nanase/japariradio/docs/index.md

---
layout: default
title: JapariRadio

header_top: true
header_title: JapariRadio
header_version: Rev.3
header_image: /assets/img/title/rev3.jpg
header_label: [supported]

subpages:
  - title: 頒布情報
    page: distribution
  - title: 更新履歴
    page: updates
---

## 特徴

JapariRadio は手のひらサイズの FM ラジオ受信機です。シンプル操作でどこでも使いやすい 2 ボタン、音量ボリュームを採用し、さらに単 4 電池 1 本から動作します。

<table class="borderless-table no-image-border less-padding foot-note text-center center-table" style="max-width: 600px">
  <tbody>
    <tr>
      <td>
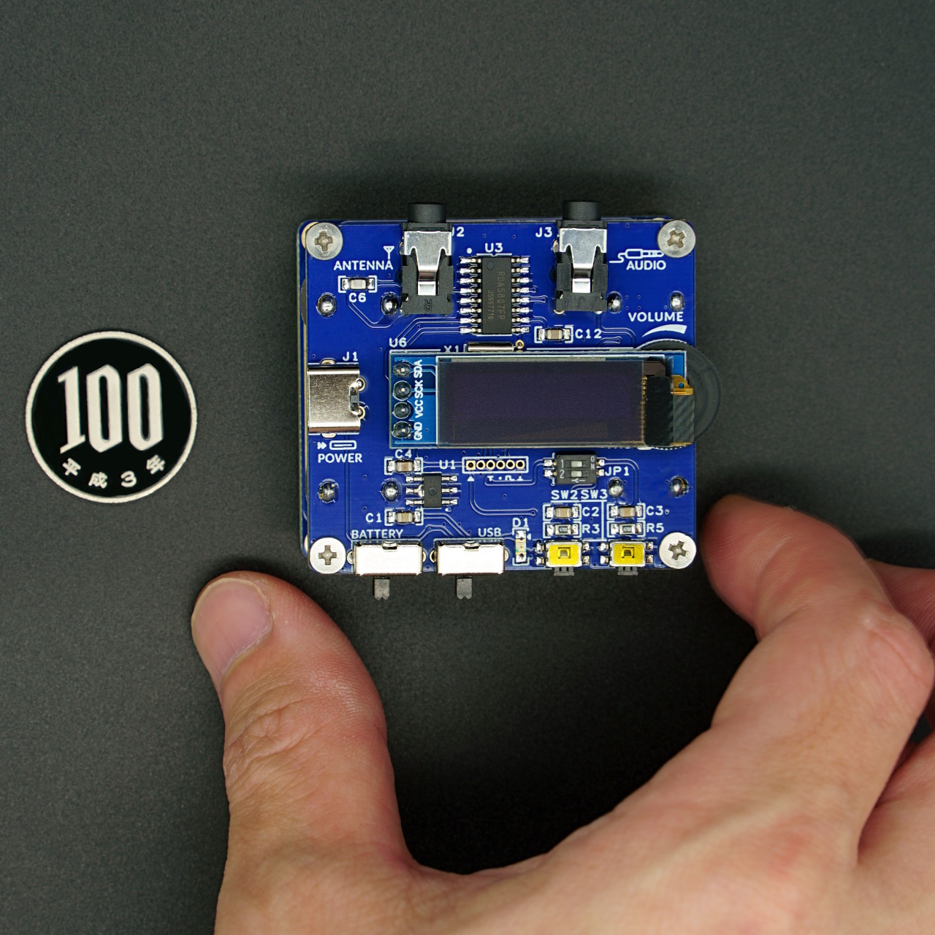
[picture p1: docs/assets/img/rev3_photo.jpg]
        <br />
        51g の手のひらサイズ<br />
        持ち歩きにも便利です
      </td>
      <td>
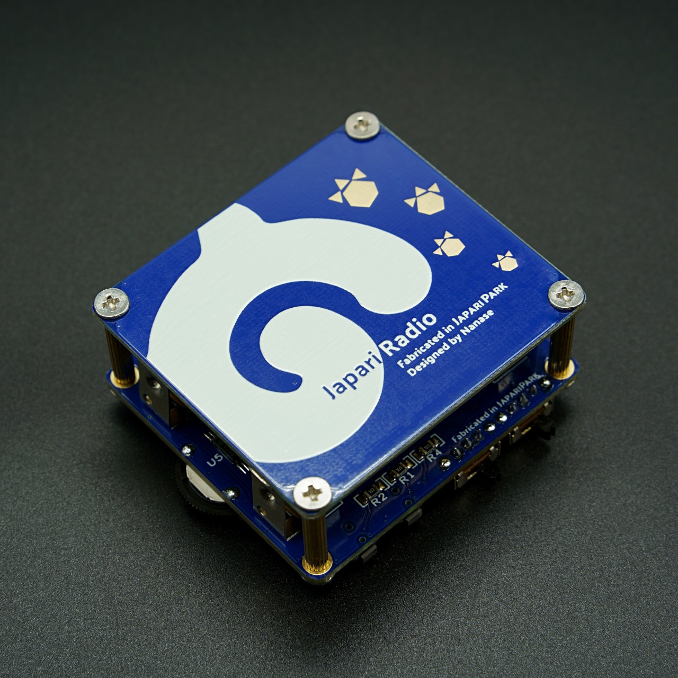
[picture p2: docs/assets/img/rev3_photo2.jpg]
        <br />
        背面は部品がなくすっきり<br />
        ロゴを目立たせています
      </td>
    </tr>
  </tbody>
</table>

## つかいかた

- 電池スイッチ：電池使用時に使います。
- USB スイッチ：未使用時は電源を切れます。
- 選局 / シークボタン：0.1 MHz ごとに選曲ができます。長押しでシークができます。
- 音量ボリューム：シンプルで使いやすいロータリーボリュームを採用しています。
- オーディオ出力ジャック：ステレオ対応の 3.5mm イヤホンジャックです。
- 外付けアンテナジャック：受信感度が低く屋内でも快適に聴取できます。

<div class="no-image-border text-center center-table" style="max-width: 600px">
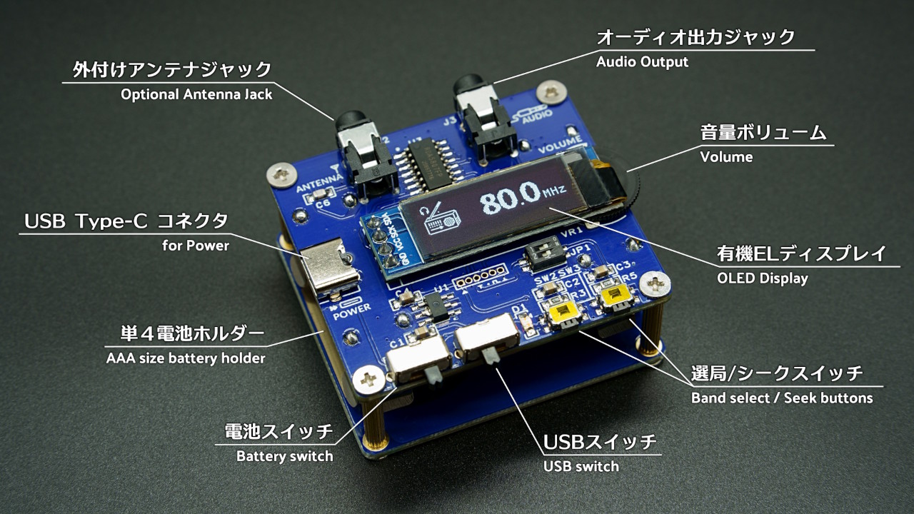
[picture p3: docs/assets/img/rev3_usage.jpg]
  
</div>

## 使用上の注意

- ディスプレイに有機 EL を使用しているため、長期間使用すると輝度に偏りが発生しますが異常ではありません。
- 受信感度が低い条件下で十分に聴取できない場合、外付けアンテナを使用すると受信感度が改善することがあります。
- 地域ごとの FM 局一覧はこちら: [NHK](https://www.nhk.or.jp/radio/info/frequency.html?ch=fm) [民放](https://www.soumu.go.jp/menu_seisaku/ictseisaku/housou_suishin/fm-list.html)

## こんなときは

- 電源が入らない、ディスプレイに何も表示されない：USB ケーブルの接続を確認してください。
- ディスプレイが暗い：受信周波数を変えてしばらくすると、省電力とディスプレイの寿命向上のため自動的に画面輝度が低くなります。再度受信周波数を変えると画面の輝度が元に戻ります。
- 雑音しか聞こえない：受信感度の高い屋外で使用するか、外付けアンテナを使ってください。

## 仕様

<table class="spec-table">
  <tbody>
    <tr>
      <th>製品名</th>
      <td>JapariRadio Rev.3</td>
    </tr>
    <tr>
      <th>製作期</th>
      <td>2022.05</td>
    </tr>
  </tbody>
</table>

<table class="spec-table">
  <tbody>
    <tr>
      <th>ラジオIC</th>
      <td>RDA5807FP</td>
    </tr>
    <tr>
      <th>受信周波数範囲</th>
      <td>76.0～108.0 MHz (0.1 MHz 刻み)</td>
    </tr>
    <tr>
      <th>出力チャネル</th>
      <td>ステレオ対応（受信可能時のみ）</td>
    </tr>
    <tr>
      <th>ボリューム</th>
      <td>基板右側面にて調整</td>
    </tr>
    <tr>
      <th>シーク機能</th>
      <td>あり（ボタン長押し）</td>
    </tr>
    <tr>
      <th>受信周波数記憶機能</th>
      <td>あり</td>
    </tr>
    <tr>
      <th>外付けアンテナ</th>
      <td>取付可能（アンテナ端子あり）</td>
    </tr>
  </tbody>
</table>

<table class="spec-table">
  <tbody>
    <tr>
      <th>ディスプレイ</th>
      <td>128x32 ドット 0.91 インチ 有機 EL ディスプレイ</td>
    </tr>
    <tr>
      <th>表示アイコン</th>
      <td>受信周波数、ステレオ受信、受信強度</td>
    </tr>
    <tr>
      <th>輝度</th>
      <td>無操作時は自動で低輝度モードへ移行、時間経過で消灯</td>
    </tr>
  </tbody>
</table>

<table class="spec-table">
  <tbody>
    <tr>
      <th>電源</th>
      <td>DC 5V (USB Type-C 端子) または 単4電池 1～2 本</td>
    </tr>
    <tr>
      <th>消費電力</th>
      <td>40mA (最大)</td>
    </tr>
  </tbody>
</table>

<table class="spec-table">
  <tbody>
    <tr>
      <th>大きさ（本体のみ）</th>
      <td>約 50.0（幅） x18.0（高さ） x45.0（奥行） mm</td>
    </tr>
    <tr>
      <th>大きさ（突起物含む）</th>
      <td>約 53.5（幅） x23.0（高さ） x52.5（奥行） mm</td>
    </tr>
    <tr>
      <th>質量</th>
      <td>約 51 g（電池含む）</td>
    </tr>
  </tbody>
</table>

## ドキュメント

<table class="spec-table">
  <tbody>
    <tr>
      <th>図面</th>
      <td class="no-image-border text-center">
        <div class="inline-block">
          <a href="{{site.baseurl}}/assets/pdf/rev3_schematics.pdf" target="_blank">
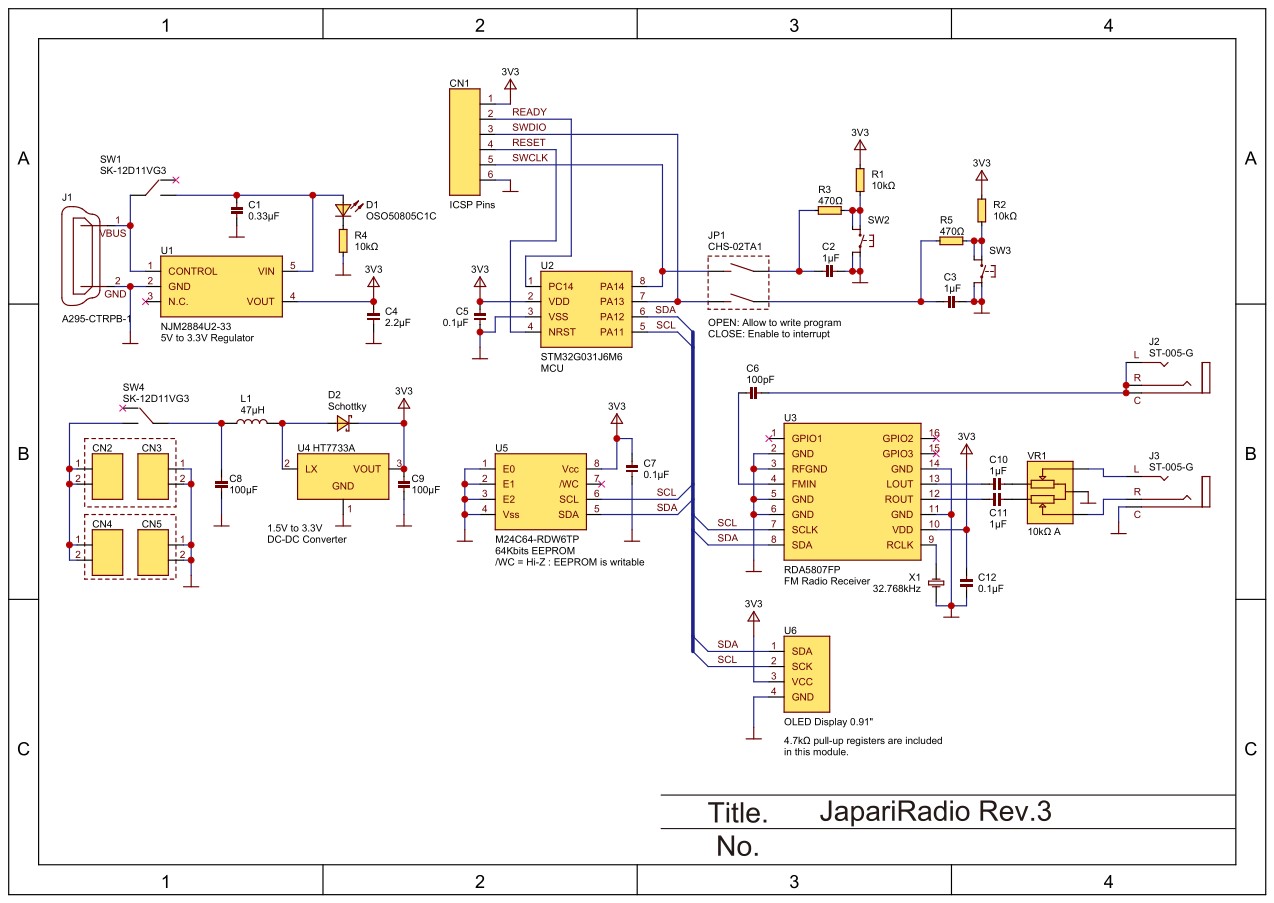
[picture p4: docs/assets/img/pdf_thumb/rev3_schematics.jpg]
            <br />
            回路図
          </a>
        </div>
        <div class="inline-block">
          <a href="{{site.baseurl}}/assets/pdf/rev3_pcb_top.pdf" target="_blank">
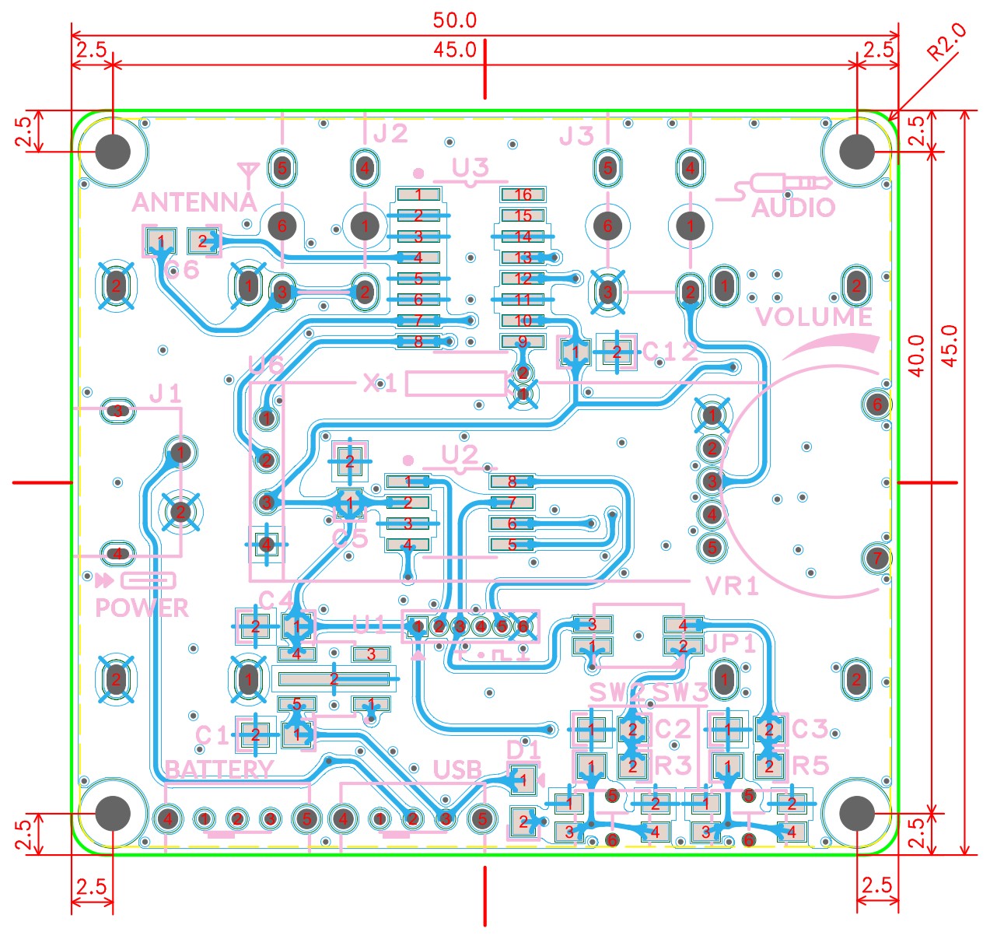
[picture p5: docs/assets/img/pdf_thumb/rev3_pcb_top.jpg]
            <br />
            基板表面
          </a>
        </div>
        <div class="inline-block">
          <a href="{{site.baseurl}}/assets/pdf/rev3_pcb_bottom.pdf" target="_blank">
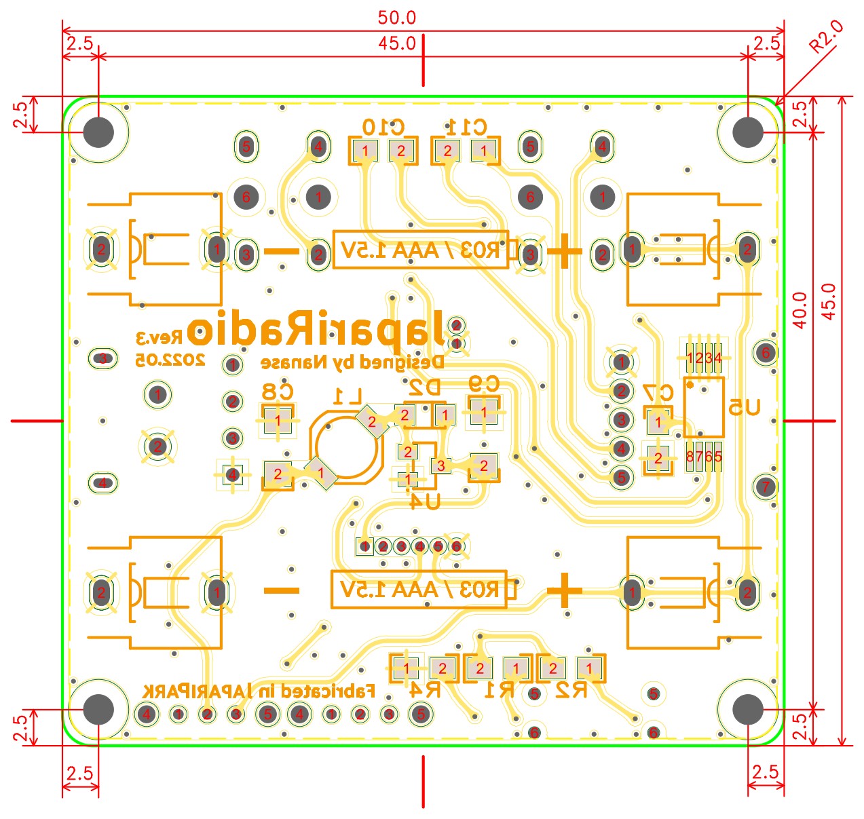
[picture p6: docs/assets/img/pdf_thumb/rev3_pcb_bottom.jpg]
            <br />
            基板裏面
          </a>
        </div>
      </td>
    </tr>
  </tbody>
</table>

## ライセンス

**この作品は「けものフレンズ」の非公式ファン作品です。** 使用により生じた損失については責任を負いかねます。

<table class="spec-table">
  <tbody>
    <tr>
      <th>
        <a href="https://fonts.google.com/specimen/Palanquin+Dark#about" target="_blank">Palanquin Dark</a><br />
        <span class="foot-note">by Pria Ravichandran</span>
      </th>
      <td>
        <span class="foot-note">Font for Logo and Text on board</span><br />
        These fonts are licensed under the <a href="https://scripts.sil.org/cms/scripts/page.php?site_id=nrsi&id=OFL" target="_blank">Open Font License</a>.
      </td>
    </tr>
    <tr>
      <th>
        <a href="https://fonts.google.com/specimen/Lato#about" target="_blank">Lato</a><br />
        <span class="foot-note">by Łukasz Dziedzic</span>
      </th>
      <td>
        <span class="foot-note">Font for Text on board</span><br />
        These fonts are licensed under the <a href="https://scripts.sil.org/cms/scripts/page.php?site_id=nrsi&id=OFL" target="_blank">Open Font License</a>.
      </td>
    </tr>
  </tbody>
</table>

<table class="spec-table">
  <tbody>
    <tr>
      <th>
        <a href="https://github.com/4ilo/ssd1306-stm32HAL" target="_blank">ssd1306-stm32HAL</a><br />
        <span class="foot-note">by 4ilo</span>
      </th>
      <td>
        <span class="foot-note">Display program and Font data</span><br />
        <a href="https://github.com/4ilo/ssd1306-stm32HAL/blob/master/LICENSE.md" target="_blank">MIT License</a>
      </td>
    </tr>
  </tbody>
</table>

## 製作・制作

- 基板設計・実装・プログラム開発：七瀬 [@nanase_coder](https://twitter.com/nanase_coder)
- スペシャルサンクス：スティルマンさん [@lp_stillman](https://twitter.com/lp_stillman)

<p class="text-center margin-50 epitaph">Designed by Nanase, Fabricated in <span class="small-caps">JapariPark</span></p>
