nanase/japariradio/docs/updates.md

---
layout: default
title: JapariRadio 更新履歴

header_top: false

subpages:
  - title: 頒布情報
    page: distribution
  - title: 更新履歴
    page: updates
---

# 更新履歴

## ファームウェア

<table class="spec-table">
  <tbody>
    <tr>
      <th>
        2022.05.04<br />
        <span class="foot-note">1.2.0 for Rev.3</span>
      </th>
      <td>
        <p>
          <a href="https://github.com/nanase/japariradio/releases/tag/v1.2.0" target="_blank">ソース・ダウンロード</a>
        </p>
        <p>
          <ul>
            <li>
              タイトル画面のアニメーションを変更しました。
            </li>
            <li>
              I<sup>2</sup>Cの速度を 100kHz から 400kHz に変更したことにともない、全体の描画速度が向上しました。
            </li>
            <li>
              OLEDディスプレイの長寿命化のため、しばらく経過すると完全にディスプレイを消灯するようにしました。
            </li>
            <li>
              周波数のドットの位置を変更しました。
            </li>
            <li>
              画面が暗くなるタイミングを変更しました。
            </li>
          </ul>
        </p>
      </td>
    </tr>
    <tr>
      <th>
        2021.03.21<br />
        <span class="foot-note">1.1.0 for Rev.1</span>
      </th>
      <td>
        <p>
          <a href="https://github.com/nanase/japariradio/releases/tag/v1.1.0" target="_blank">ソース・ダウンロード</a>
        </p>
        <p>
          <ul>
            <li>
              タイトル画像を追加しました。
            </li>
            <li>
              電源投入直後に選曲ができない問題を修正しました。
            </li>
            <li>
              バイナリファイルのサイズを削減しました。
            </li>
          </ul>
        </p>
      </td>
    </tr>
    <tr>
      <th>
        2021.02.08<br />
        <span class="foot-note">1.0.0 for Rev.1</span>
      </th>
      <td>
        <p>
          <a href="https://github.com/nanase/japariradio/releases/tag/v1.0.0" target="_blank">ソース・ダウンロード</a>
        </p>
        <p>
          公開
        </p>
      </td>
    </tr>
  </tbody>
</table>

## 基板

<table class="spec-table">
  <tbody>
    <tr>
      <th>
        2022.05.04<br />
        <span class="foot-note">Rev.3</span>
      </th>
      <td>
        <ul>
          <li>
            単4電池に対応しました。それにともない、電池用のスライドスイッチを追加しました。
          </li>
          <li>
            タクトスイッチを表面実装部品に変更しました。
          </li>
          <li>
            電源確認用のLEDを追加しました。
          </li>
          <li>
            USB給電をマイクロ端子からType-C端子に変更しました。
          </li>
          <li>
            プログラム書き換え用のICSPパッドの仕様を変更しました。また、書き換え用のジャンパをスイッチに変更しました。
          </li>
          <li>
            外装ケースをアクリルから変更し、プリント基板および真鍮スペーサに変更しました。
          </li>
        </ul>
        <div class="no-image-border text-center">
          <div class="inline-block">
            <a href="{{site.baseurl}}/assets/pdf/rev3_schematics.pdf" target="_blank">
              <br />
              回路図
            </a>
          </div>
          <div class="inline-block">
            <a href="{{site.baseurl}}/assets/pdf/rev3_pcb_top.pdf" target="_blank">
              <br />
              基板表面
            </a>
          </div>
          <div class="inline-block">
            <a href="{{site.baseurl}}/assets/pdf/rev3_pcb_bottom.pdf" target="_blank">
              <br />
              基板裏面
            </a>
          </div>
        </div>
      </td>
    </tr>
    <tr>
      <th>
        2021.02.08<br />
        <span class="foot-note">Rev.1</span>
      </th>
      <td>
        <ul>
          <li>
            公開
          </li>
        </ul>
        <div class="no-image-border text-center">
          <div class="inline-block">
            <a href="{{site.baseurl}}/assets/pdf/rev1_schematics.pdf" target="_blank">
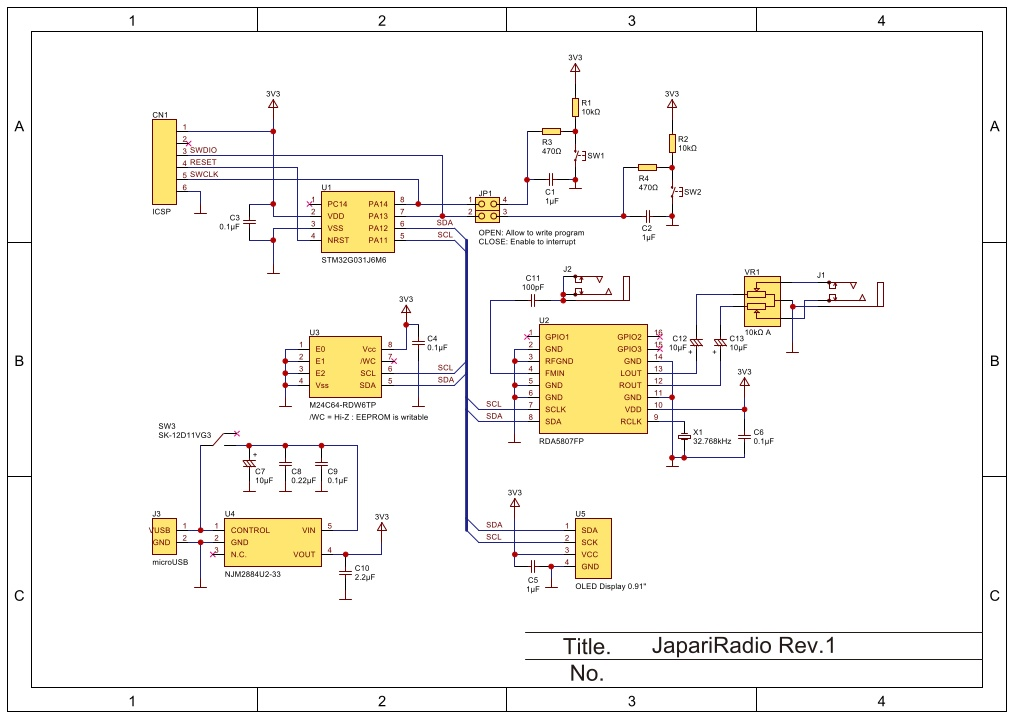
[picture p7: docs/assets/img/pdf_thumb/rev1_schematics.jpg]
              <br />
              回路図
            </a>
          </div>
          <div class="inline-block">
            <a href="{{site.baseurl}}/assets/pdf/rev1_pcb_top.pdf" target="_blank">
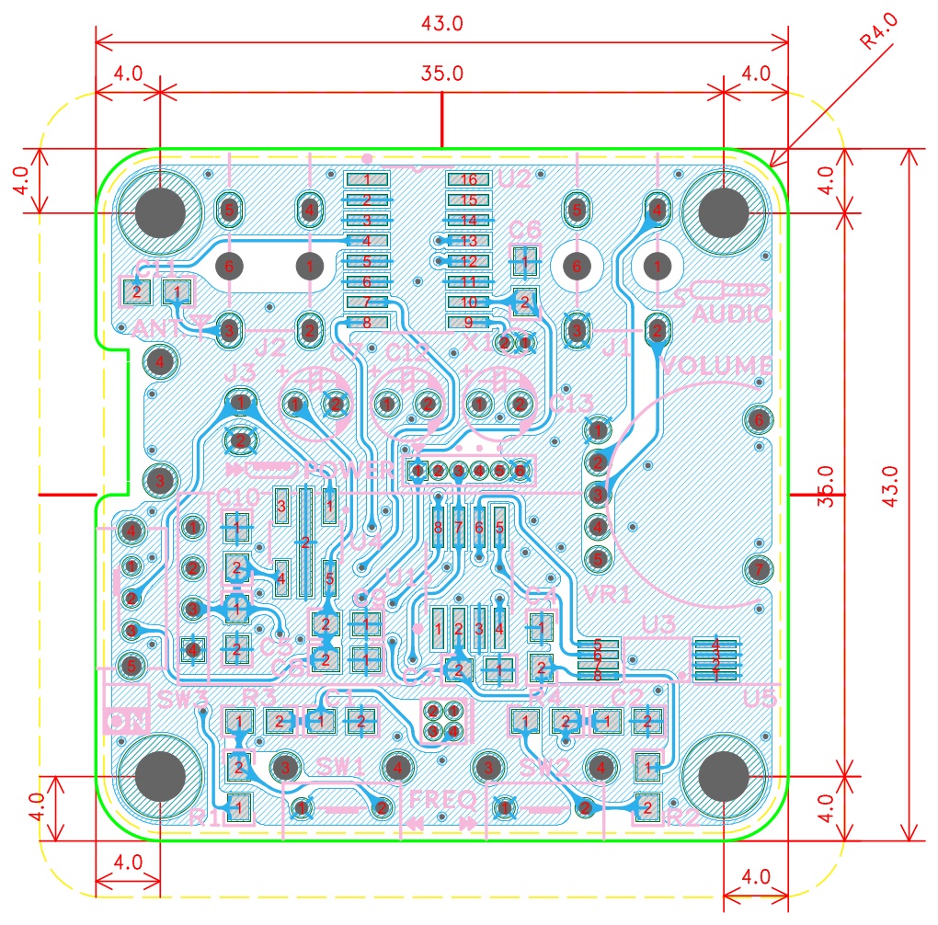
[picture p8: docs/assets/img/pdf_thumb/rev1_pcb_top.jpg]
              <br />
              基板表面
            </a>
          </div>
          <div class="inline-block">
            <a href="{{site.baseurl}}/assets/pdf/rev1_pcb_bottom.pdf" target="_blank">
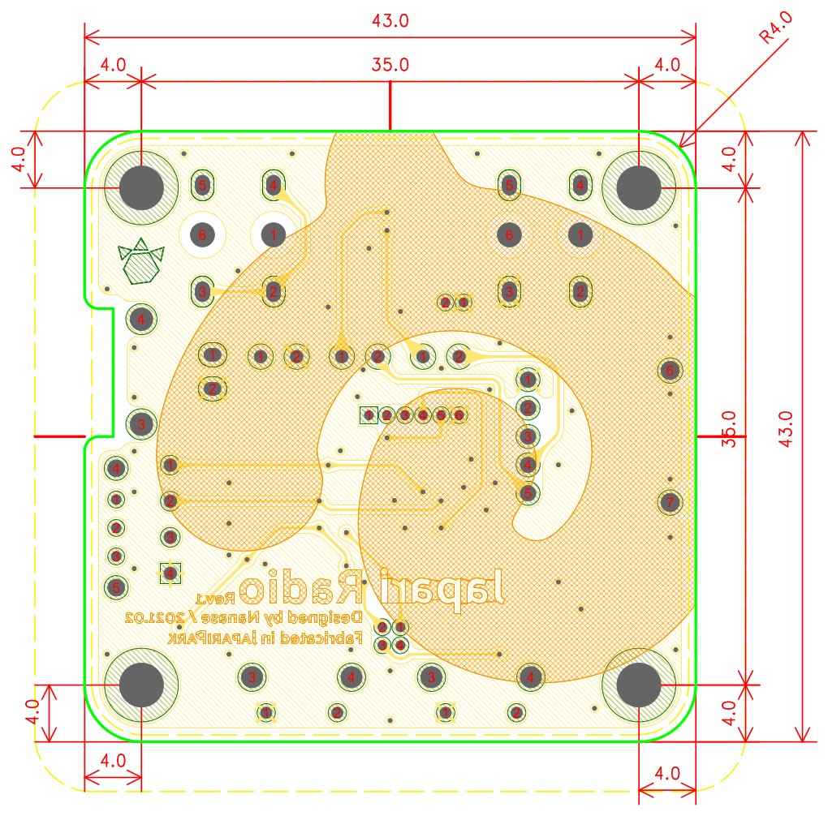
[picture p9: docs/assets/img/pdf_thumb/rev1_pcb_bottom.jpg]
              <br />
              基板裏面
            </a>
          </div>
        </div>
      </td>
    </tr>
  </tbody>
</table>
