nanase/japariradio/docs/distribution.md

---
layout: default
title: JapariRadio 頒布情報

header_top: false

subpages:
  - title: 頒布情報
    page: distribution
  - title: 更新履歴
    page: updates
---

# 頒布情報

<table class="spec-table">
  <tbody>
    <tr>
      <th>
        <p>
          2022.05.04 (祝・水) みどりの日<br />
          11:00-15:00<br />
          <a href="https://friendsihoo.tumblr.com/" target="_blank">フレンズチホー19</a><br />
          <span class="foot-note">(フレンズチホー18)</span><br />
          <span class="foot-note">(都立産業貿易センター 台東館)</span>
        </p>
        <p>
          「けもフレ電子工作部」<br />
          配置: A-04
        </p>
      </th>
      <td>
        <p>
          完成品の頒布および展示を行います。単 4 電池 2 本が付属します。
        </p>
        <p>
          仕様:
          <ul>
            <li>ハードウェア: Rev.3</li>
            <li>ファーム: v1.2.0</li>
          </ul>
        </p>
      </td>
    </tr>
    <tr>
      <th>
        <p>
          2021.04.04 (日)<br />
          11:00-15:00<br />
          <a href="https://friendsihoo.tumblr.com/" target="_blank">フレンズチホー15</a><br />
          <span class="foot-note">(東京ビッグサイト 西3ホール)</span>
        </p>
        <p>
          「けもフレ電子工作部」<br />
          配置: E-07
        </p>
      </th>
      <td>
        <p>
          完成品の頒布を行います。アクリルパネル、取扱説明書が付属します。<br />
          <a href="https://twitter.com/nanase_coder/status/1377962695702421506" target="_blank">告知ツイート</a>
        </p>
        <p>
          仕様:
          <ul>
            <li>ハードウェア: Rev.1</li>
            <li>ファーム: v1.1.0</li>
          </ul>
        </p>
        <p>
          仕様変更（変更後）:
          <ul>
            <li>スペーサ材質: 樹脂製</li>
            <li>大きさ（ケース含む）: 約 50.0（幅） x22.0（高さ） x50.0（奥行） mm</li>
            <li>重さ: 約 32 g</li>
          </ul>
        </p>
      </td>
    </tr>
  </tbody>
</table>
