nanase/japariradio/docs/assets/img/rev1_inputs.jpg

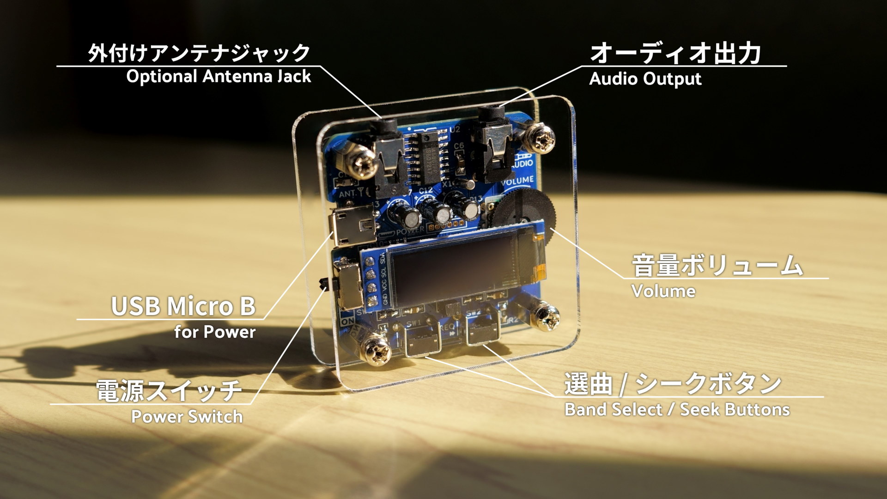
docs/assets/img/rev1_inputs.jpg
