nanase/japariradio/docs/assets/img/rev1_photo2.jpg

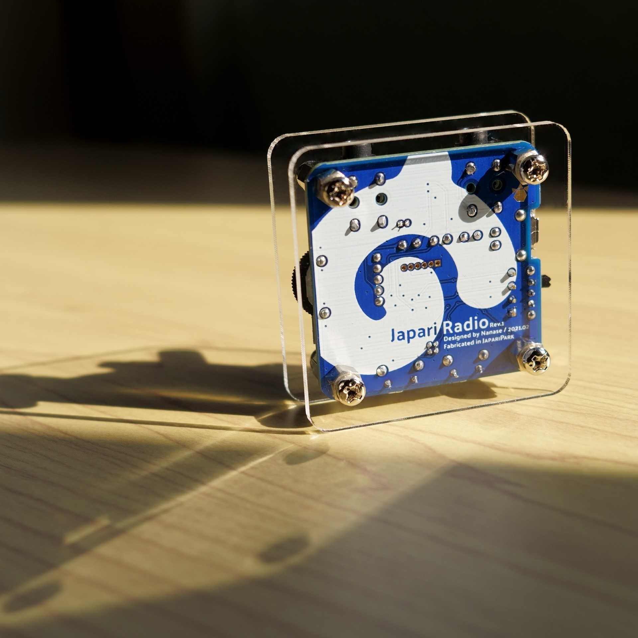
docs/assets/img/rev1_photo2.jpg
