nanase/japariradio/docs/assets/img/rev1_photo2_hd.jpg

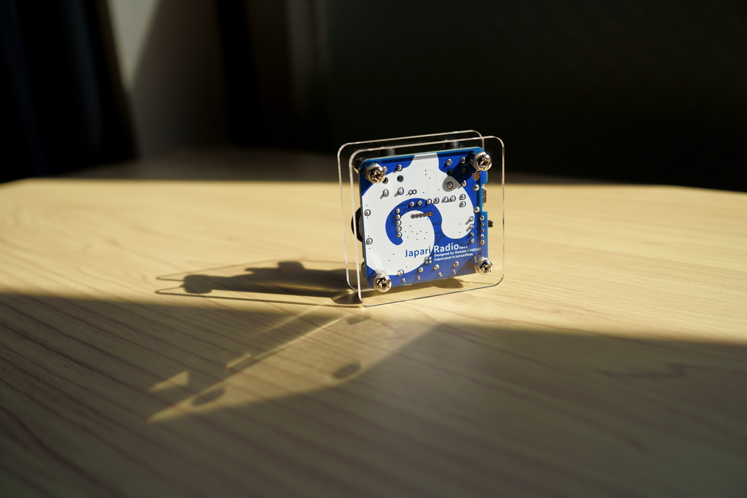
docs/assets/img/rev1_photo2_hd.jpg
