nanase/japariradio/docs/assets/img/rev1_photo.jpg

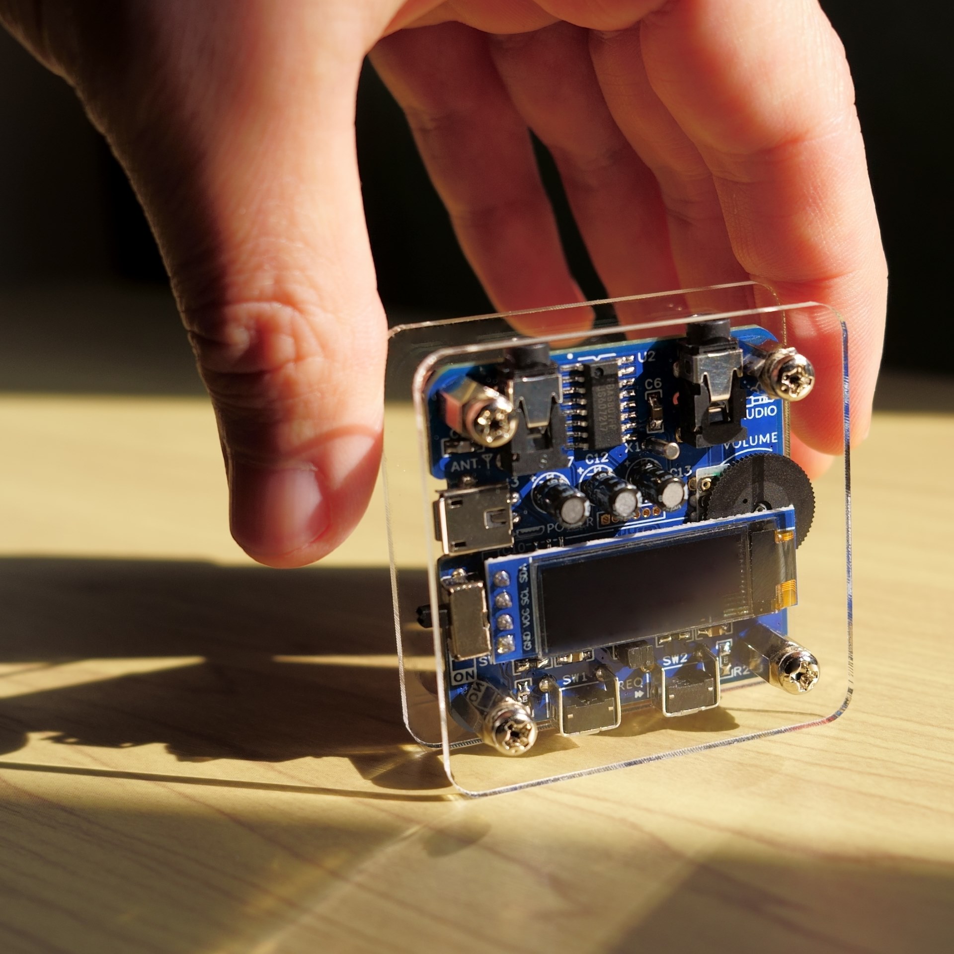
docs/assets/img/rev1_photo.jpg
