nanase/japariradio/docs/assets/img/rev1_photo_hd.jpg

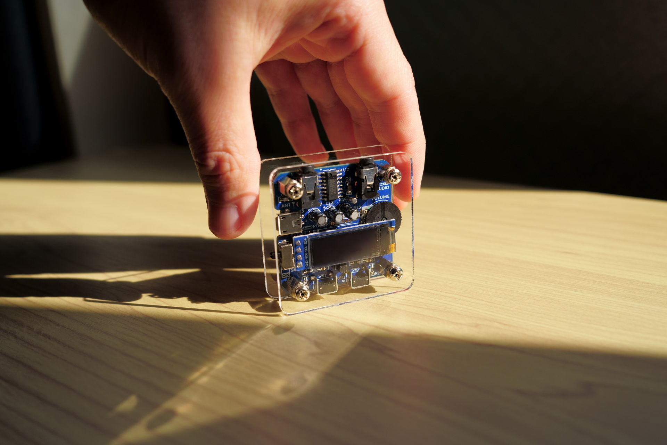
docs/assets/img/rev1_photo_hd.jpg
