nanase/japariradio/docs/assets/img/rev3_photo2_hd.jpg

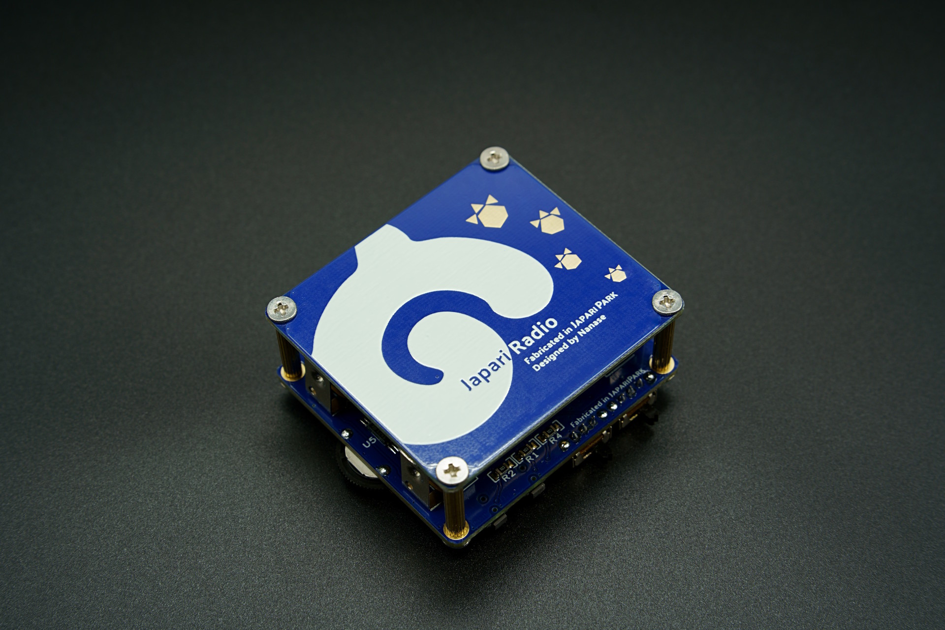
docs/assets/img/rev3_photo2_hd.jpg
