nanase/japariradio/docs/assets/img/rev3_photo_hd.jpg

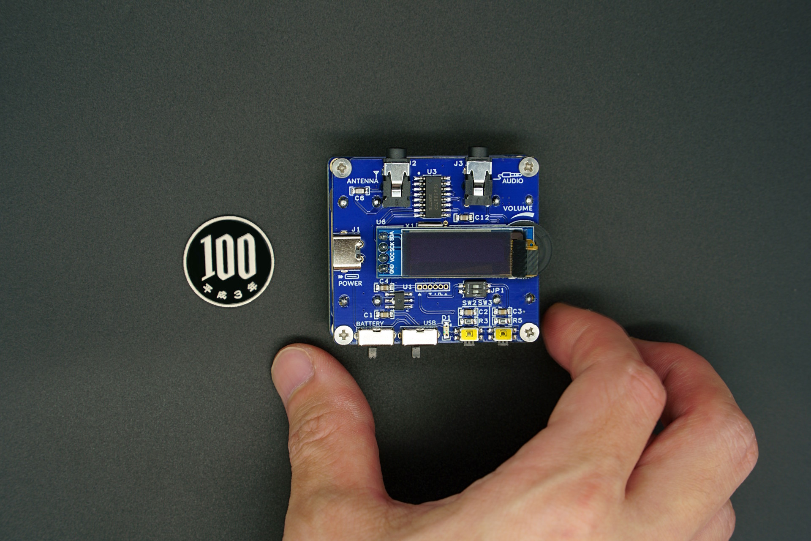
docs/assets/img/rev3_photo_hd.jpg
