nanase/japariradio/docs/assets/img/title/rev1.jpg

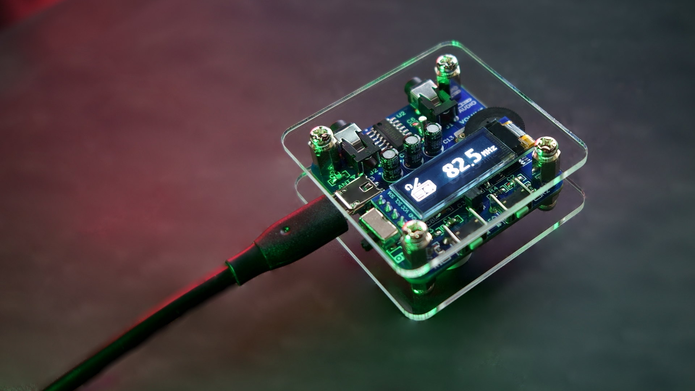
docs/assets/img/title/rev1.jpg
