nanase/japariradio/docs/assets/img/title/rev3.jpg

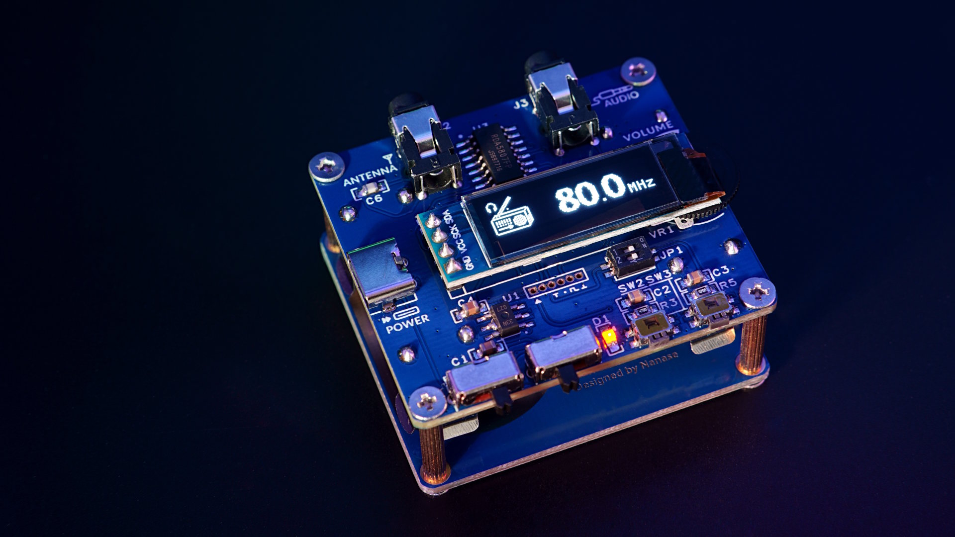
docs/assets/img/title/rev3.jpg
