nanase/japariradio/(threads)

Thread 1 (2021-03-21):

電源投入直後の周波数の選局ができない

nanase, 2021-03-21:
## 背景

電源投入直後、EEPROMに保存された周波数に合わせても選局ができず聴取できない。

周波数を上下させると選局できるので、電源投入直後はRDA5807は選局できないことが原因である可能性が高い。

## 解決方針

電源投入直後の周波数設定に時間を置く。

### デメリット

ウェイトにもよるが特に無し

Closed 2021-03-21.
