nanase/japariradio/docs/assets/pdf/rev3_schematics.pdf

1

2

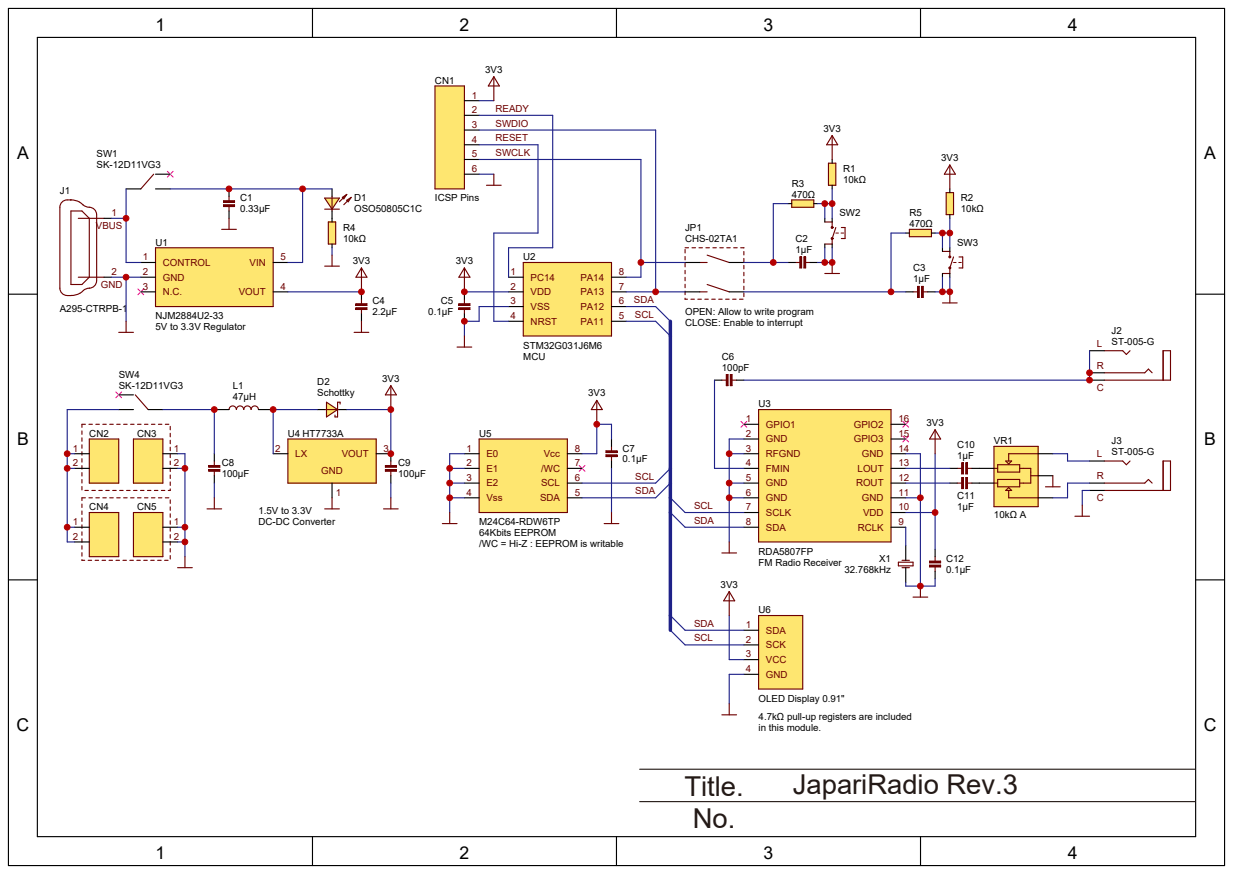
[picture p19: page 1]

OPEN: Allow to write program
CLOSE: Enable to interrupt

M24C64-RDW6TP
64Kbits EEPROM
/WC = Hi-Z : EEPROM is writable

OLED Display 0.91"
4.7kΩ pull-up registers are included
in this module.
JapariRadio Rev.3
