nanase/japariradio/docs/assets/pdf/rev3_pcb_bottom.pdf

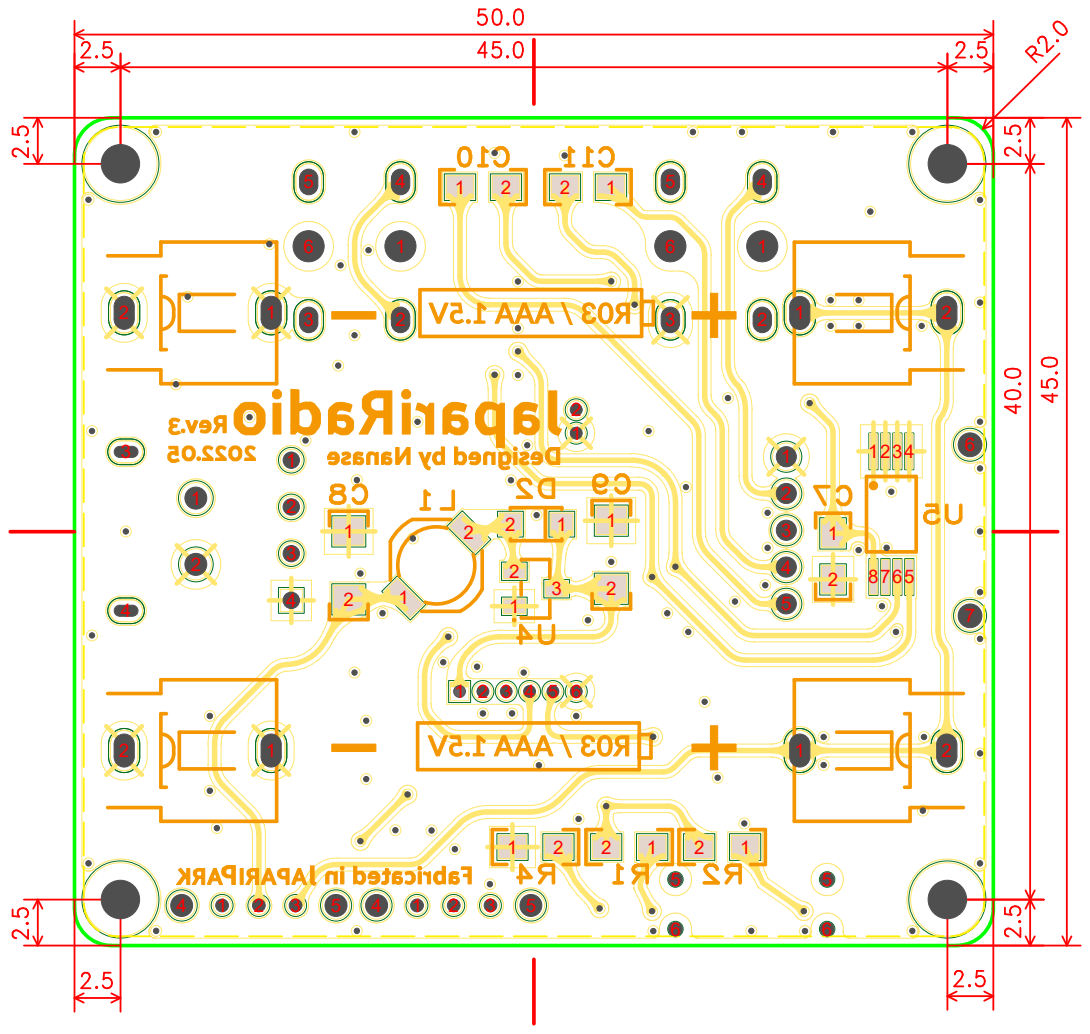
[picture p20: page 1]
