nanase/japariradio/docs/assets/pdf/rev3_pcb_top.pdf

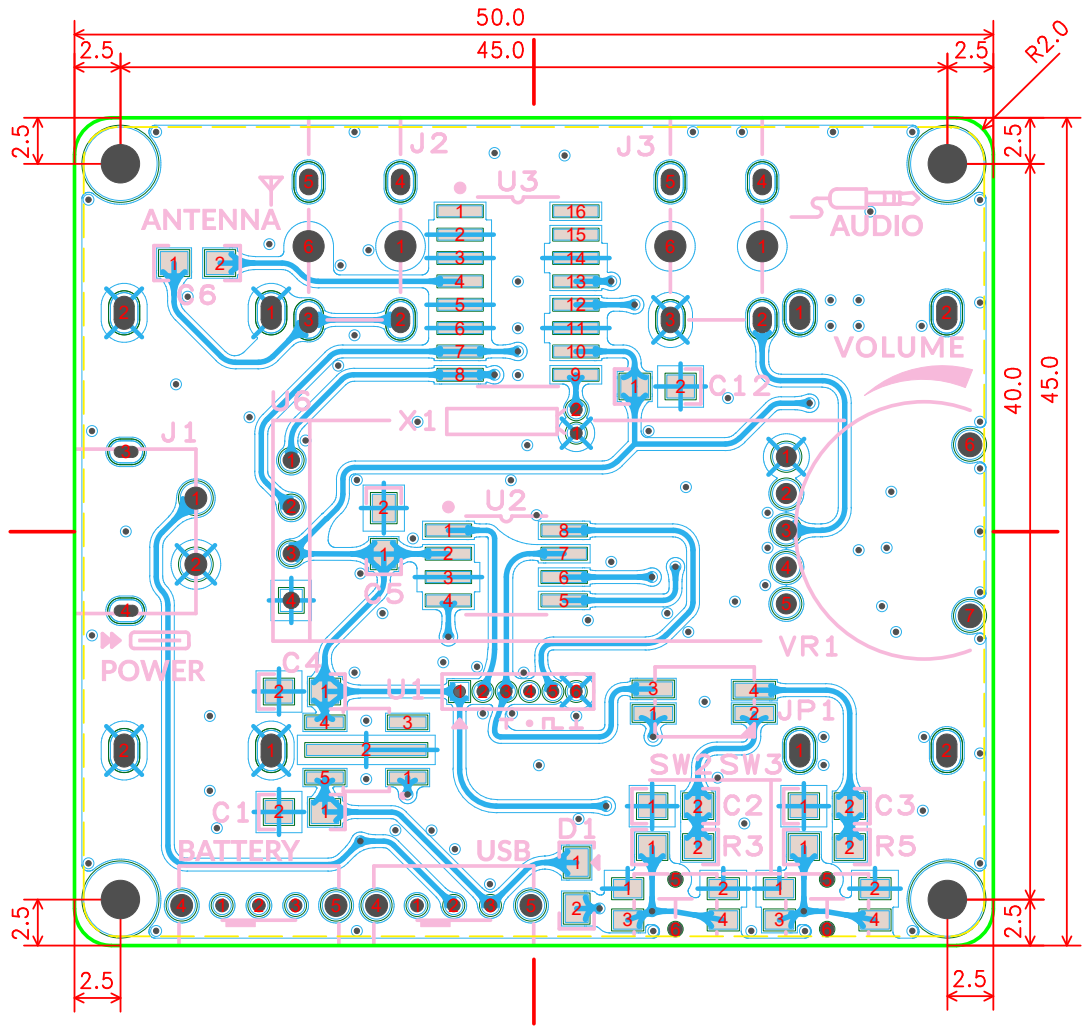
[picture p21: page 1]
