nanase/japariradio/docs/assets/pdf/rev1_schematics.pdf

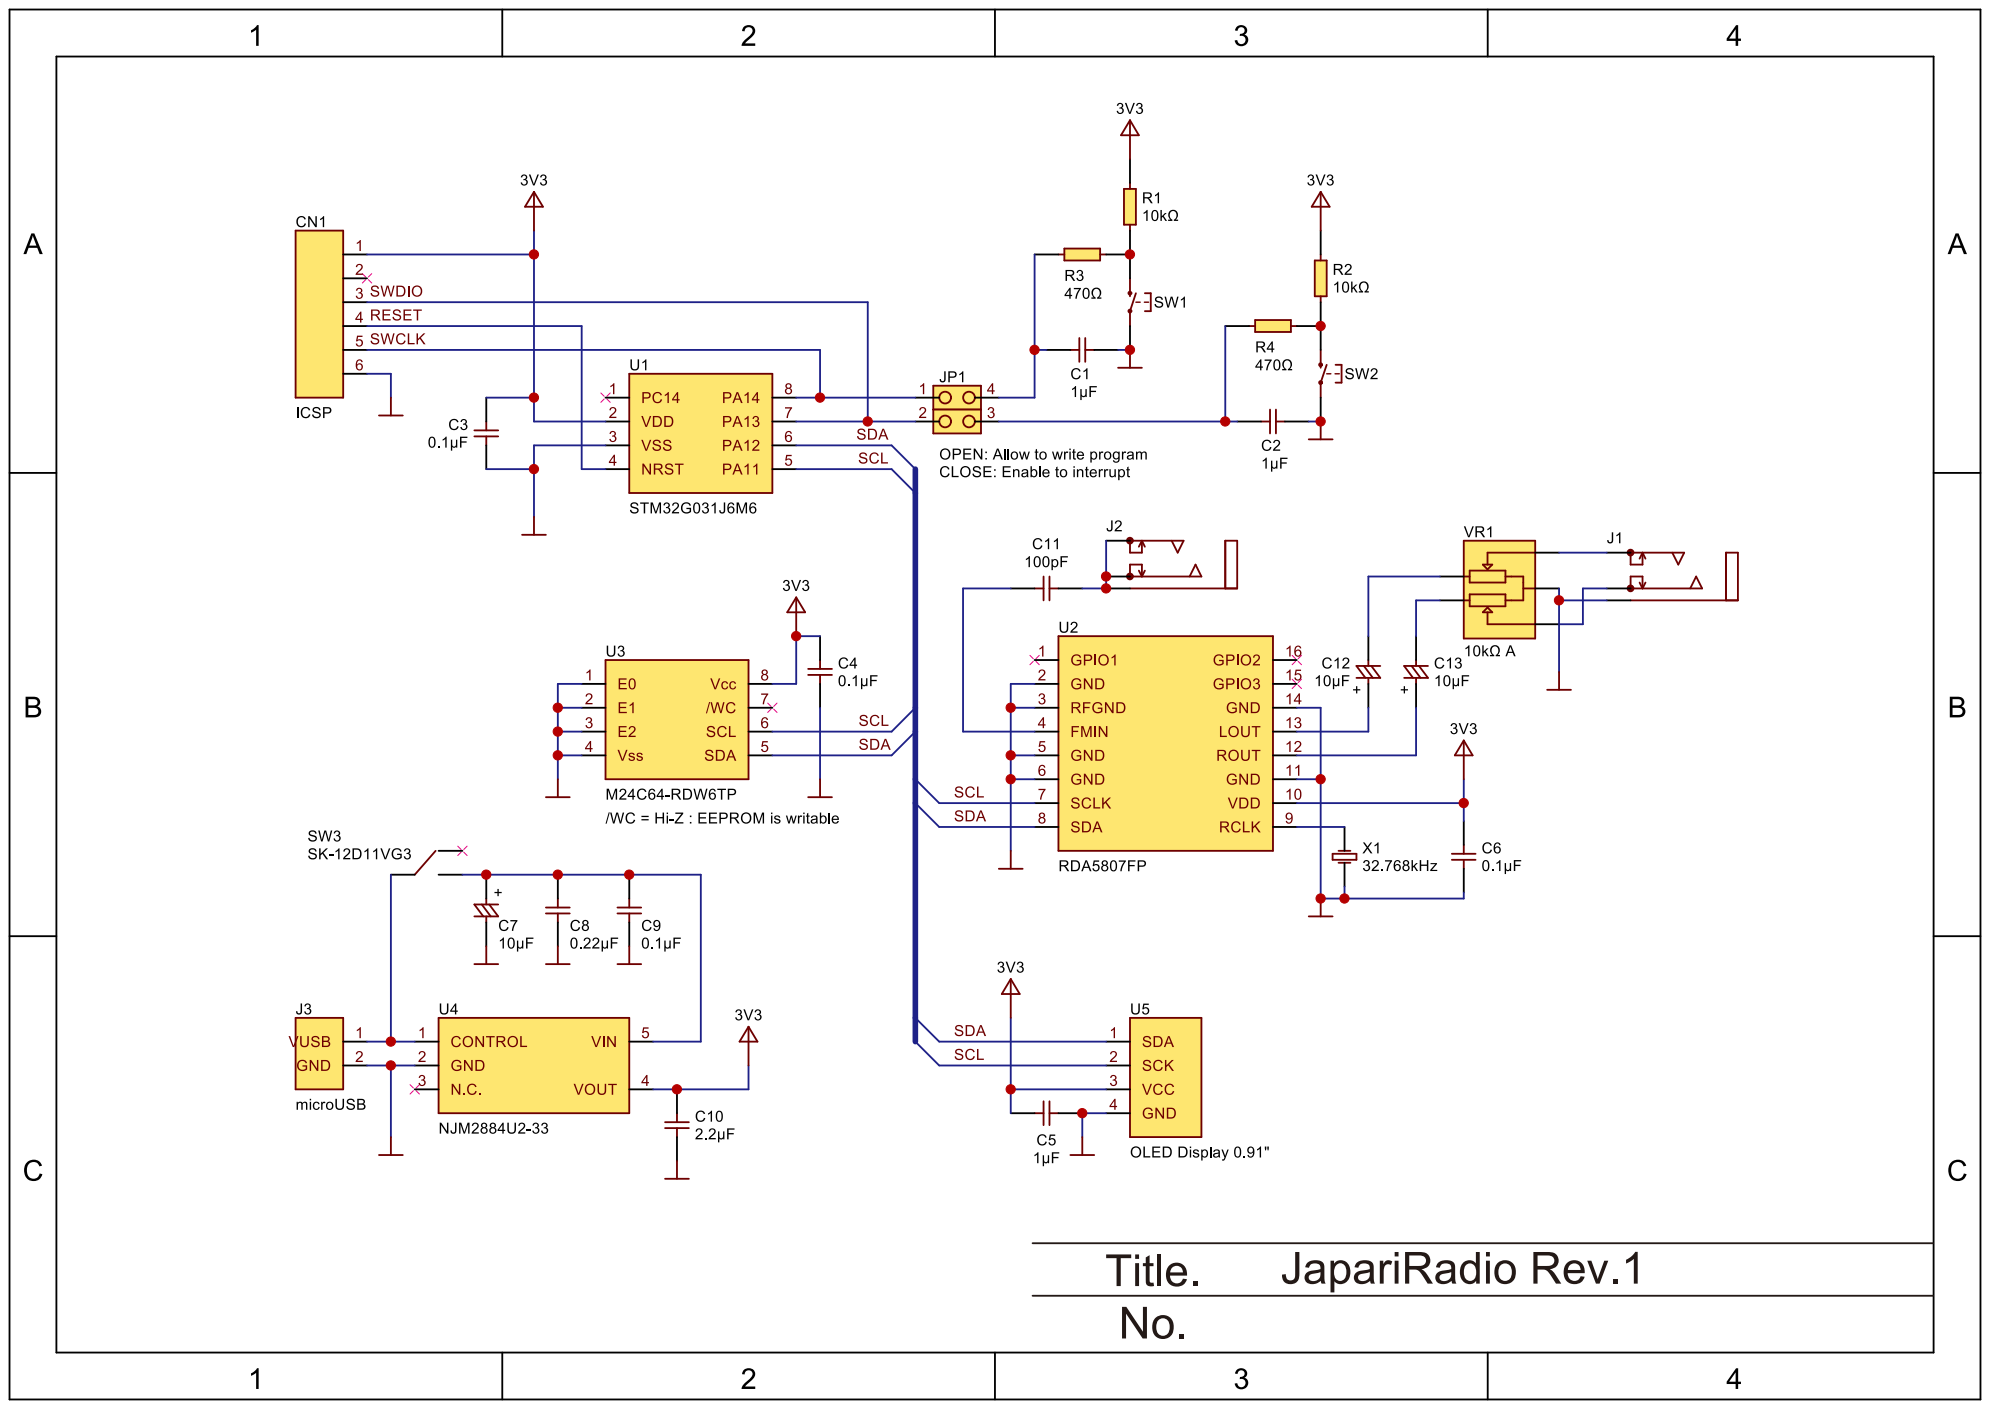
[picture p22: page 1]
