nanase/japariradio/docs/assets/pdf/rev1_pcb_bottom.pdf

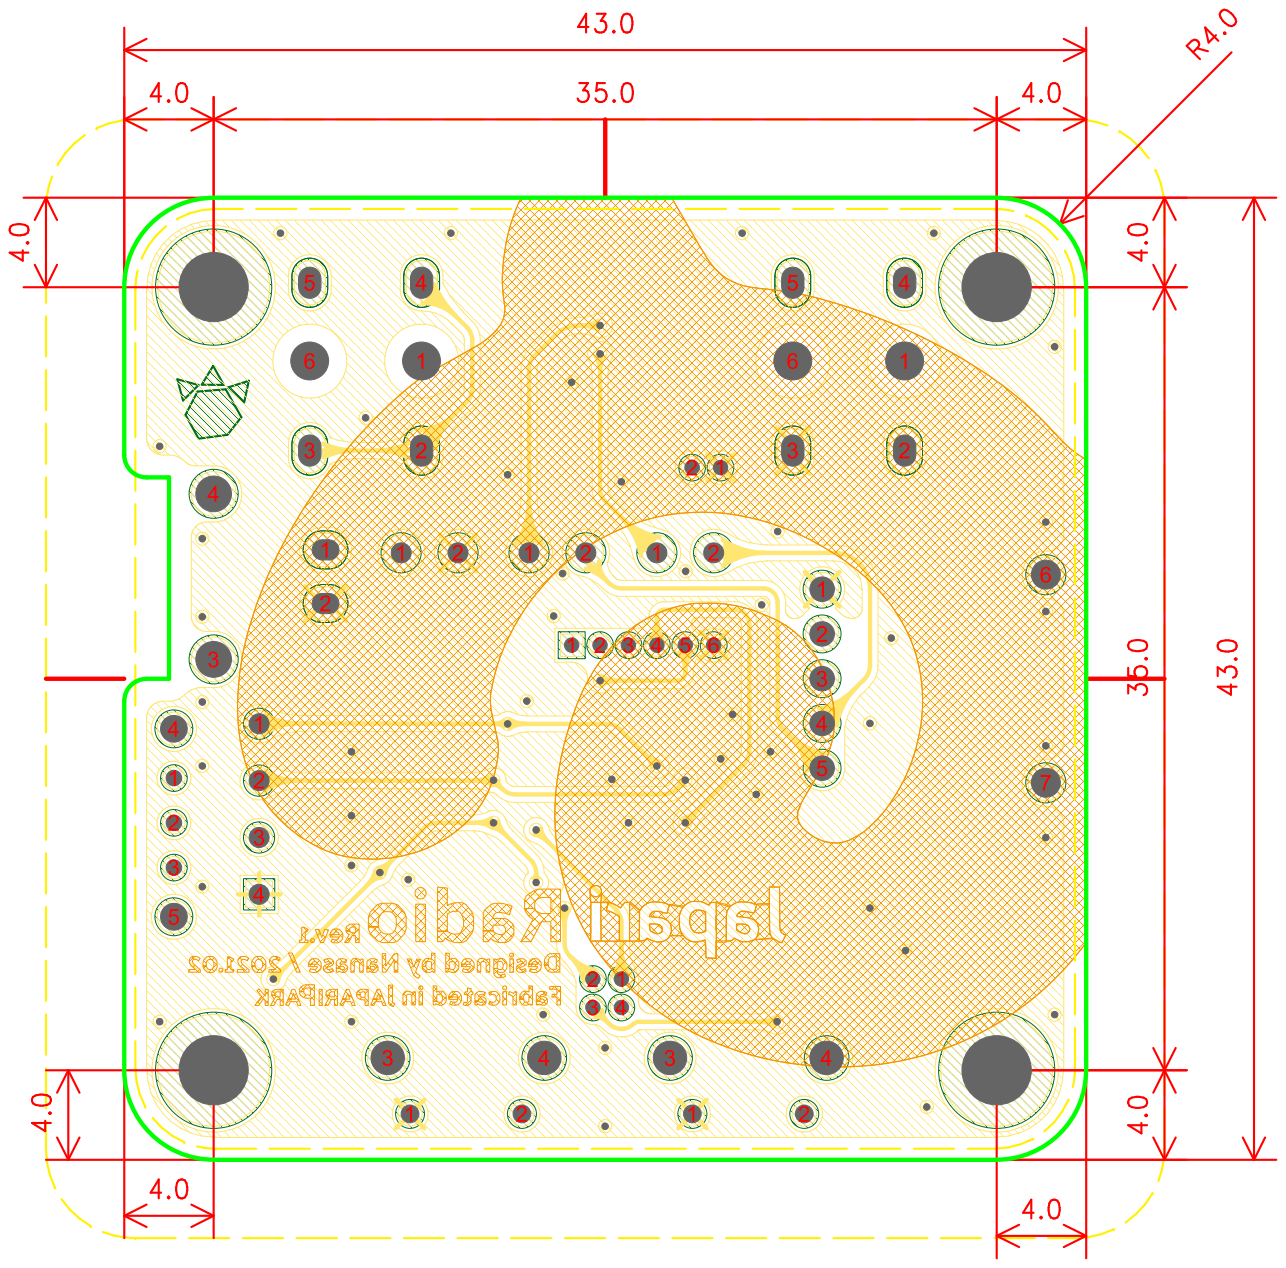
[picture p23: page 1]
