nanase/japariradio/docs/assets/pdf/rev1_pcb_top.pdf

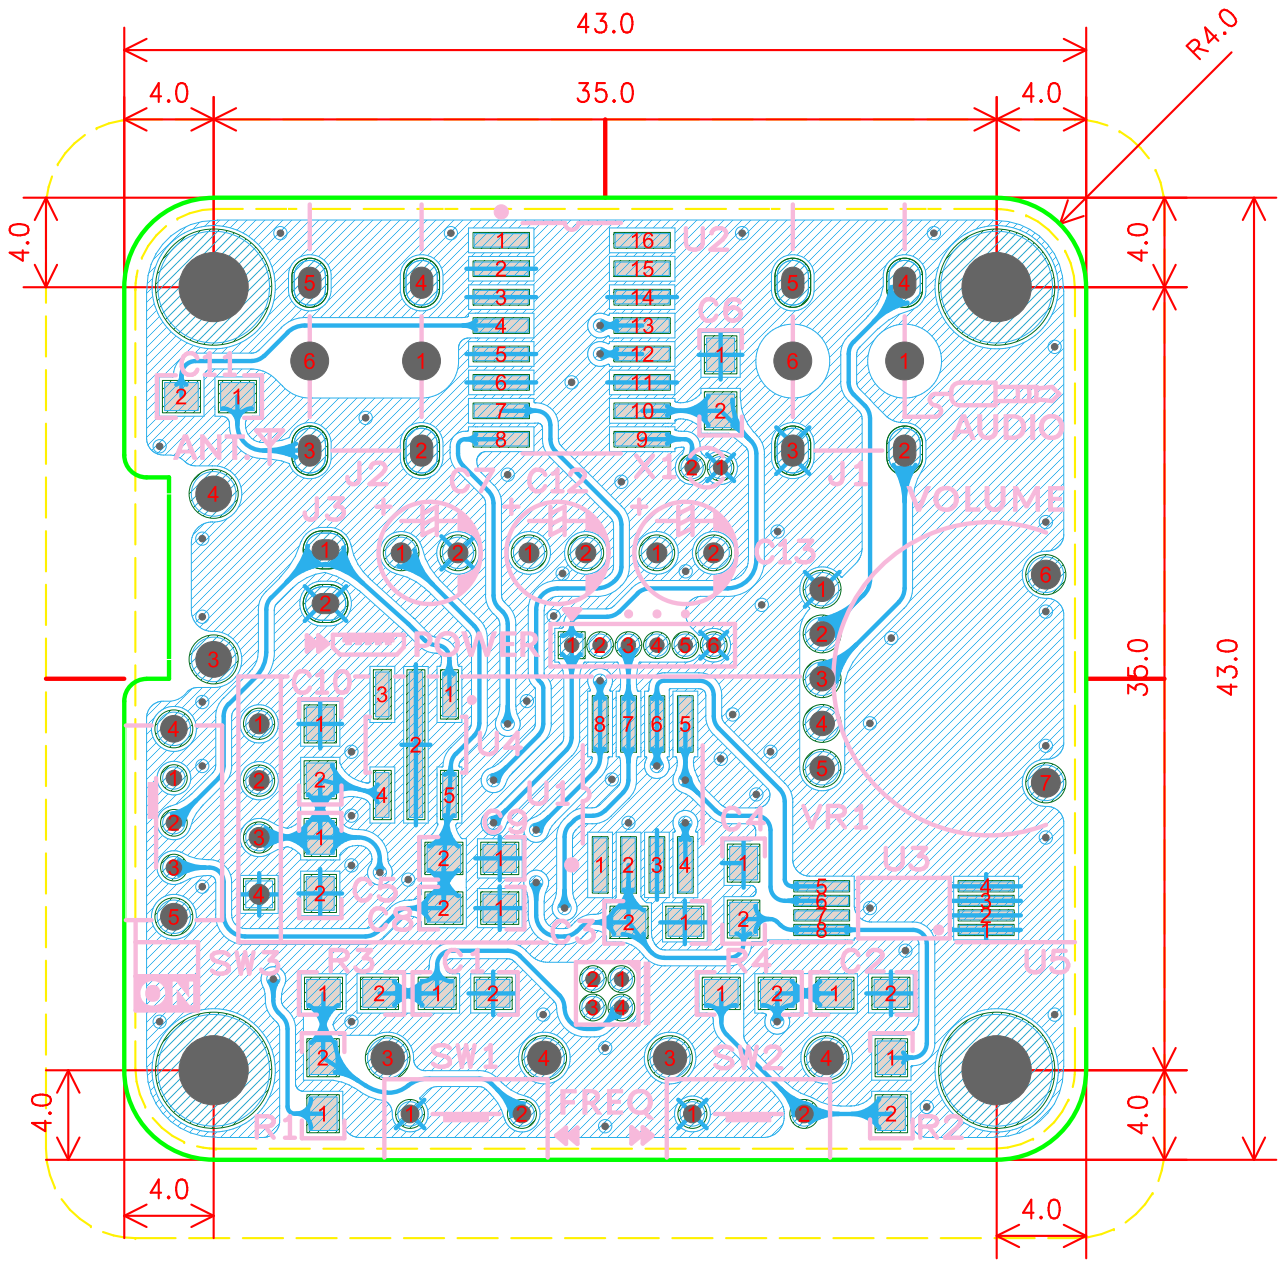
[picture p24: page 1]
