nanase/japariradio/(commit log)

2021-02-08 GitHub Pages追加
2021-02-09 画像追加と文言修正
2021-02-09 文言修正
2021-02-09 回路図と基板図面追加
2021-02-18 faviconを追加
2021-02-18 けもフレ電子工作部へのリンクを追加
2021-03-07 Makefilke修正
    - デバッグビルド解除
    - 最適化オプションを Os に変更、LTO有効化
    - ソースファイルの指定をワイルドカードに変換
    - LDFLAGSに nosys 指定、メモリ使用率を表示
    - OBJECTSの指定方法の誤りを修正
    - 不要な空白文字を削除
2021-03-21 タイトルイメージ追加と電源投入直後に選曲ができない問題を修正 (close #1)
2021-03-21 バージョン表記を1.1.0に変更
2021-03-21 更新履歴ページを更新
2021-04-03 頒布情報を更新
2021-04-03 会場の脱字修正
2022-04-04 iocファイルとライブラリの更新
2022-04-04 .gitignore更新
    FLASH.ldを管理するように
    build/ 以下のファイルは追跡なし
2022-04-04 .c, .h を .cpp, .hpp に変更
2022-04-04 イメージファイルを統合
2022-04-04 バージョン改定
2022-04-04 Makefileを更新
    - デバッグビルドを有効化
    - LTOを無効化
    - cppに変更したソースへの対応
2022-04-05 I2Cの速度を400kHzに高速化
2022-04-05 関数cImage_writeCropYを追加
2022-04-05 タイトル画面のアニメーションを変更
2022-04-05 I2C高速化に伴う画面更新タイミングの調整
2022-04-05 一定時間が経過したらディスプレイの表示をオフにするよう機能追加
2022-04-05 未使用の文字をコメントアウト
2022-04-24 sup, subのvertical-alignが適用されるように修正
2022-04-24 頒布情報と更新履歴を更新
2022-04-24 Rev3の写真と仕様に更新
